xiaprojects/rb-pcb/RB-01/rb01hat/docs/generated/gpio-map.md

<!-- GENERATED by tools/netlist.py from hardware/*.csv - do not edit by hand. Run `make docs` after changing the CSVs. -->

# GPIO map - Raspberry Pi 5 40-pin header

Physical pin numbers are the header positions (pin 1 = square pad, notch end). BCM = GPIO number used by software (gpiozero, libgpiod, device tree).

## Pin-by-pin

| Pin | Name | BCM | Net | Connected to | Status / notes |
|---:|---|---:|---|---|---|
| 1 | 3V3 |  | 3V3 | 3V3 rail | used <br><sub>3.3 V supply (switched off in STANDBY)</sub> |
| 2 | 5V |  |  |  | not wired on HAT (same rail as the wired pins) <br><sub>5 V from USB-C input (present in STANDBY)</sub> |
| 3 | GPIO2 | 2 | I2C1_SDA | U1.SDA, U7.SDA | used <br><sub>I2C1 SDA; on-board ~1.8k pull-up to 3V3</sub> |
| 4 | 5V |  | 5V | 5V rail | used <br><sub>5 V</sub> |
| 5 | GPIO3 | 3 | I2C1_SCL | U1.SCL, U7.SCL | used <br><sub>I2C1 SCL; on-board ~1.8k pull-up to 3V3</sub> |
| 6 | GND |  | GND | GND rail | used |
| 7 | GPIO4 | 4 |  |  | **rb-ems** - RB-EMS: FLARM OUT (UART2 TXD) to the traffic annunciators - off-HAT <br><sub>GPCLK0; UART2 TXD (Pi 5 uart2-pi5)</sub> |
| 8 | GPIO14 | 14 |  |  | **rb-ems** - RB-EMS: UART GPS TXD - off-HAT <br><sub>UART0 TXD</sub> |
| 9 | GND |  |  |  | not wired on HAT (same rail as the wired pins) |
| 10 | GPIO15 | 15 |  |  | **rb-ems** - RB-EMS: UART GPS RXD - off-HAT <br><sub>UART0 RXD</sub> |
| 11 | GPIO17 | 17 |  |  | **rb-ems** - RB-EMS: 5th MAX31856 CS on SPI1 (ems-chtegt.json outsidetemperature; v3.0 image: OIL T.) - not in the HAT list <br><sub>SPI1 CE1</sub> |
| 12 | GPIO18 | 18 |  |  | **reserved** - SPI1 CE0 is driven by spidev1.0 (dtoverlay=spi1-1cs): do not connect (RB-EMS scheme) <br><sub>SPI1 CE0; PCM CLK; PWM0</sub> |
| 13 | GPIO27 | 27 | CHT4_CS_N | R4.2, U6.CS | used |
| 14 | GND |  |  |  | not wired on HAT (same rail as the wired pins) |
| 15 | GPIO22 | 22 |  |  | **rb-ems** - RB-EMS: engine RPM pulse input (ems-rpm.json enginerpm) - off-HAT |
| 16 | GPIO23 | 23 | EGT1_CS_N | R5.2, J11.7, J12.7, U9.CS | used |
| 17 | 3V3 |  | 3V3 | 3V3 rail | used <br><sub>3.3 V supply</sub> |
| 18 | GPIO24 | 24 | EGT3_CS_N | R7.2, J11.9, J12.9, U11.CS | used |
| 19 | GPIO10 | 10 | SPI0_MOSI | J11.4, J12.4, U9.SDI, U10.SDI, U11.SDI, U12.SDI | used <br><sub>SPI0 MOSI</sub> |
| 20 | GND |  | GND | GND rail | used |
| 21 | GPIO9 | 9 | SPI0_MISO | J11.5, J12.5, U9.SDO, U10.SDO, U11.SDO, U12.SDO | used <br><sub>SPI0 MISO</sub> |
| 22 | GPIO25 | 25 |  |  | **rb-ems** - RB-EMS: landing gear NOSE switch (ems-gpio.json gearnose) - off-HAT |
| 23 | GPIO11 | 11 | SPI0_SCLK | J11.3, J12.3, U9.SCK, U10.SCK, U11.SCK, U12.SCK | used <br><sub>SPI0 SCLK</sub> |
| 24 | GPIO8 | 8 | EGT2_CS_N | R6.2, J11.8, J12.8, U10.CS | used <br><sub>SPI0 CE0</sub> |
| 25 | GND |  | GND | GND rail | used |
| 26 | GPIO7 | 7 | EGT4_CS_N | R8.2, J11.10, J12.10, U12.CS | used <br><sub>SPI0 CE1</sub> |
| 27 | GPIO0 | 0 | I2C0_SDA | R11.2, U2.SDA, U13.SDA (DNP), U14.LSDA | used <br><sub>ID_SD; I2C0 SDA (Pi 5 i2c0-pi5)</sub> |
| 28 | GPIO1 | 1 | I2C0_SCL | R12.2, U2.SCL, U13.SCL (DNP), U14.LSCL | used <br><sub>ID_SC; I2C0 SCL (Pi 5 i2c0-pi5)</sub> |
| 29 | GPIO5 | 5 |  |  | **rb-ems** - RB-EMS v3.0 scheme: UART group with FLARM (UART2 RXD) - off-HAT; function to confirm <br><sub>UART2 RXD (Pi 5 uart2-pi5)</sub> |
| 30 | GND |  |  |  | not wired on HAT (same rail as the wired pins) |
| 31 | GPIO6 | 6 | CHT3_CS_N | R3.2, U5.CS | used |
| 32 | GPIO12 | 12 |  |  | **rb-ems** - RB-EMS: landing gear LEFT switch (ems-gpio.json gearleft) - off-HAT <br><sub>PWM0</sub> |
| 33 | GPIO13 | 13 | CHT1_CS_N | R1.2, U3.CS | used <br><sub>PWM1</sub> |
| 34 | GND |  |  |  | not wired on HAT (same rail as the wired pins) |
| 35 | GPIO19 | 19 | SPI1_MISO | U3.SDO, U4.SDO, U5.SDO, U6.SDO | used <br><sub>SPI1 MISO; PCM FS</sub> |
| 36 | GPIO16 | 16 |  |  | **rb-ems** - RB-EMS: landing gear RIGHT switch (ems-gpio.json gearright) - off-HAT <br><sub>SPI1 CE2</sub> |
| 37 | GPIO26 | 26 | CHT2_CS_N | R2.2, U4.CS | used |
| 38 | GPIO20 | 20 | SPI1_MOSI | U3.SDI, U4.SDI, U5.SDI, U6.SDI | used <br><sub>SPI1 MOSI; PCM DIN</sub> |
| 39 | GND |  | GND | GND rail | used |
| 40 | GPIO21 | 21 | SPI1_SCLK | U3.SCK, U4.SCK, U5.SCK, U6.SCK | used <br><sub>SPI1 SCLK; PCM DOUT</sub> |

## Header view (top of HAT, GPIO edge at the top, USB/Ethernet to the right)

Odd pins are the row nearer the board centre on the Pi; even pins are the row on the board edge.

| Net | Name | Pin | Pin | Name | Net |
|---|---|---:|:---|---|---|
| 3V3 | 3V3 | 1 | 2 | 5V |  |
| I2C1_SDA | GPIO2 | 3 | 4 | 5V | 5V |
| I2C1_SCL | GPIO3 | 5 | 6 | GND | GND |
|  | GPIO4 | 7 | 8 | GPIO14 |  |
|  | GND | 9 | 10 | GPIO15 |  |
|  | GPIO17 | 11 | 12 | GPIO18 |  |
| CHT4_CS_N | GPIO27 | 13 | 14 | GND |  |
|  | GPIO22 | 15 | 16 | GPIO23 | EGT1_CS_N |
| 3V3 | 3V3 | 17 | 18 | GPIO24 | EGT3_CS_N |
| SPI0_MOSI | GPIO10 | 19 | 20 | GND | GND |
| SPI0_MISO | GPIO9 | 21 | 22 | GPIO25 |  |
| SPI0_SCLK | GPIO11 | 23 | 24 | GPIO8 | EGT2_CS_N |
| GND | GND | 25 | 26 | GPIO7 | EGT4_CS_N |
| I2C0_SDA | GPIO0 | 27 | 28 | GPIO1 | I2C0_SCL |
|  | GPIO5 | 29 | 30 | GND |  |
| CHT3_CS_N | GPIO6 | 31 | 32 | GPIO12 |  |
| CHT1_CS_N | GPIO13 | 33 | 34 | GND |  |
| SPI1_MISO | GPIO19 | 35 | 36 | GPIO16 |  |
| CHT2_CS_N | GPIO26 | 37 | 38 | GPIO20 | SPI1_MOSI |
| GND | GND | 39 | 40 | GPIO21 | SPI1_SCLK |

## Signals by GPIO (allocation vs. priority)

| BCM | Pin | Net | Nodes | Highest-priority user |
|---:|---:|---|---|---|
| 0 | 27 | I2C0_SDA | R11.2, U2.SDA, U13.SDA (DNP), U14.LSDA | P2 U2 (Air quality T/RH/P/gas) |
| 1 | 28 | I2C0_SCL | R12.2, U2.SCL, U13.SCL (DNP), U14.LSCL | P2 U2 (Air quality T/RH/P/gas) |
| 2 | 3 | I2C1_SDA | U1.SDA, U7.SDA | P1 U1 (9-axis IMU) |
| 3 | 5 | I2C1_SCL | U1.SCL, U7.SCL | P1 U1 (9-axis IMU) |
| 6 | 31 | CHT3_CS_N | R3.2, U5.CS | P3 U5 (Thermocouple CHT3) |
| 7 | 26 | EGT4_CS_N | R8.2, J11.10, J12.10, U12.CS | P6 U12 (Thermocouple EGT4) |
| 8 | 24 | EGT2_CS_N | R6.2, J11.8, J12.8, U10.CS | P6 U10 (Thermocouple EGT2) |
| 9 | 21 | SPI0_MISO | J11.5, J12.5, U9.SDO, U10.SDO, U11.SDO, U12.SDO | P6 U9 (Thermocouple EGT1) |
| 10 | 19 | SPI0_MOSI | J11.4, J12.4, U9.SDI, U10.SDI, U11.SDI, U12.SDI | P6 U9 (Thermocouple EGT1) |
| 11 | 23 | SPI0_SCLK | J11.3, J12.3, U9.SCK, U10.SCK, U11.SCK, U12.SCK | P6 U9 (Thermocouple EGT1) |
| 13 | 33 | CHT1_CS_N | R1.2, U3.CS | P3 U3 (Thermocouple CHT1) |
| 19 | 35 | SPI1_MISO | U3.SDO, U4.SDO, U5.SDO, U6.SDO | P3 U3 (Thermocouple CHT1) |
| 20 | 38 | SPI1_MOSI | U3.SDI, U4.SDI, U5.SDI, U6.SDI | P3 U3 (Thermocouple CHT1) |
| 21 | 40 | SPI1_SCLK | U3.SCK, U4.SCK, U5.SCK, U6.SCK | P3 U3 (Thermocouple CHT1) |
| 23 | 16 | EGT1_CS_N | R5.2, J11.7, J12.7, U9.CS | P6 U9 (Thermocouple EGT1) |
| 24 | 18 | EGT3_CS_N | R7.2, J11.9, J12.9, U11.CS | P6 U11 (Thermocouple EGT3) |
| 26 | 37 | CHT2_CS_N | R2.2, U4.CS | P3 U4 (Thermocouple CHT2) |
| 27 | 13 | CHT4_CS_N | R4.2, U6.CS | P3 U6 (Thermocouple CHT4) |

## I2C address map

| Bus | Address | Ref | Function | Part | Fitted |
|---|---|---|---|---|---|
| I2C0 | 0x48 | U8 | 4-ch 16-bit ADC | ADS1115 breakout | yes |
| I2C0 | 0x50 | U13 | HAT ID EEPROM | CAT24C32 (SOIC-8) | no (DNP) |
| I2C0 | 0x77 | U2 | Air quality T/RH/P/gas | BME680 breakout | yes |
| I2C1 | 0x28 | U7 | Differential pressure (airspeed) | MS4525DO-DS3AI001DP | yes |
| I2C1 | 0x69 | U1 | 9-axis IMU | ICM-20948 breakout (1.8 V VDDIO + level shifter) | yes |

The ICM-20948 magnetometer (AK09916) also appears at 0x0C on I2C1 when the IMU is put in I2C bypass mode (the bring-up script does this).

## SPI chip-select map

| Ref | Function | Priority | Bus | CS net | BCM | Pin | Location |
|---|---|---:|---|---|---:|---:|---|
| U3 | Thermocouple CHT1 | P3 | SPI1 | CHT1_CS_N | 13 | 33 | HAT-Z3 |
| U4 | Thermocouple CHT2 | P3 | SPI1 | CHT2_CS_N | 26 | 37 | HAT-Z3 |
| U5 | Thermocouple CHT3 | P3 | SPI1 | CHT3_CS_N | 6 | 31 | HAT-Z3 |
| U6 | Thermocouple CHT4 | P3 | SPI1 | CHT4_CS_N | 27 | 13 | HAT-Z3 |
| U9 | Thermocouple EGT1 | P6 | SPI0 | EGT1_CS_N | 23 | 16 | EXT |
| U10 | Thermocouple EGT2 | P6 | SPI0 | EGT2_CS_N | 8 | 24 | EXT |
| U11 | Thermocouple EGT3 | P6 | SPI0 | EGT3_CS_N | 24 | 18 | EXT |
| U12 | Thermocouple EGT4 | P6 | SPI0 | EGT4_CS_N | 7 | 26 | EXT |
