xiaprojects/rb-pcb/RB-01/rb01hat/hardware/kicad/rb01hat-concept/renders/rb01hat-concept-right.jpg

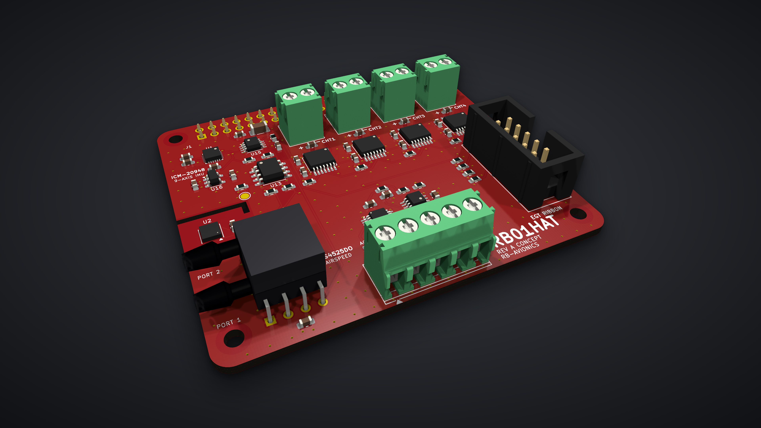
RB-01/rb01hat/hardware/kicad/rb01hat-concept/renders/rb01hat-concept-right.jpg
