xiaprojects/rb-pcb/RB-01/rb01hat/hardware/kicad/rb01hat-concept/3dmodels/SOT-23-5.step

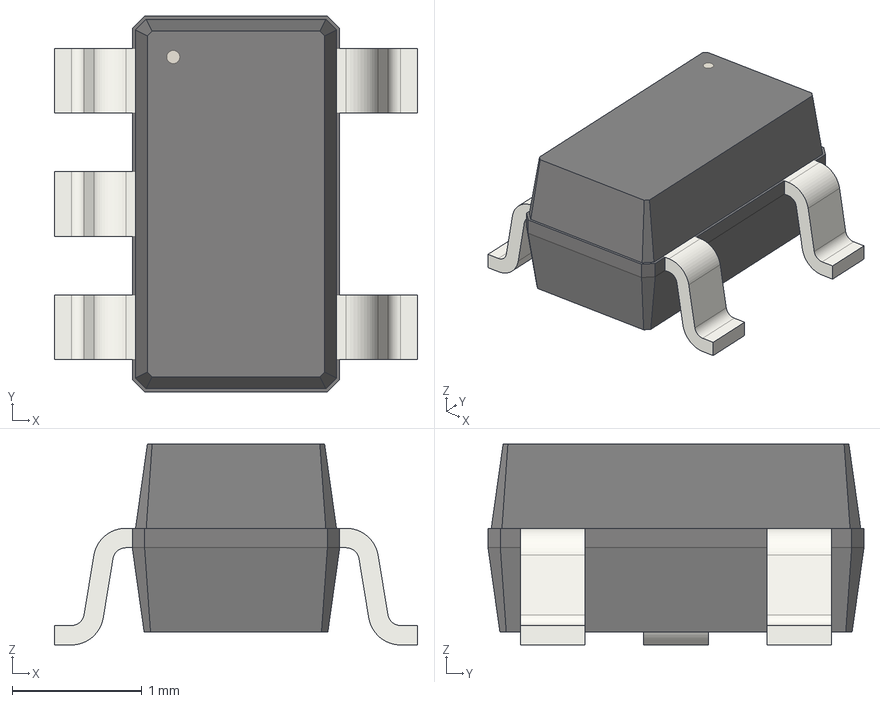
[picture p5: CAD file, 2026-11-07]
RB-01/rb01hat/hardware/kicad/rb01hat-concept/3dmodels/SOT-23-5.step
2.80 x 2.90 x 1.55 mm
