xiaprojects/rb-pcb/RB-01/rb01hat/hardware/kicad/rb01hat-concept/3dmodels/IDC-Header_2x05_P2.54mm_Vertical.step

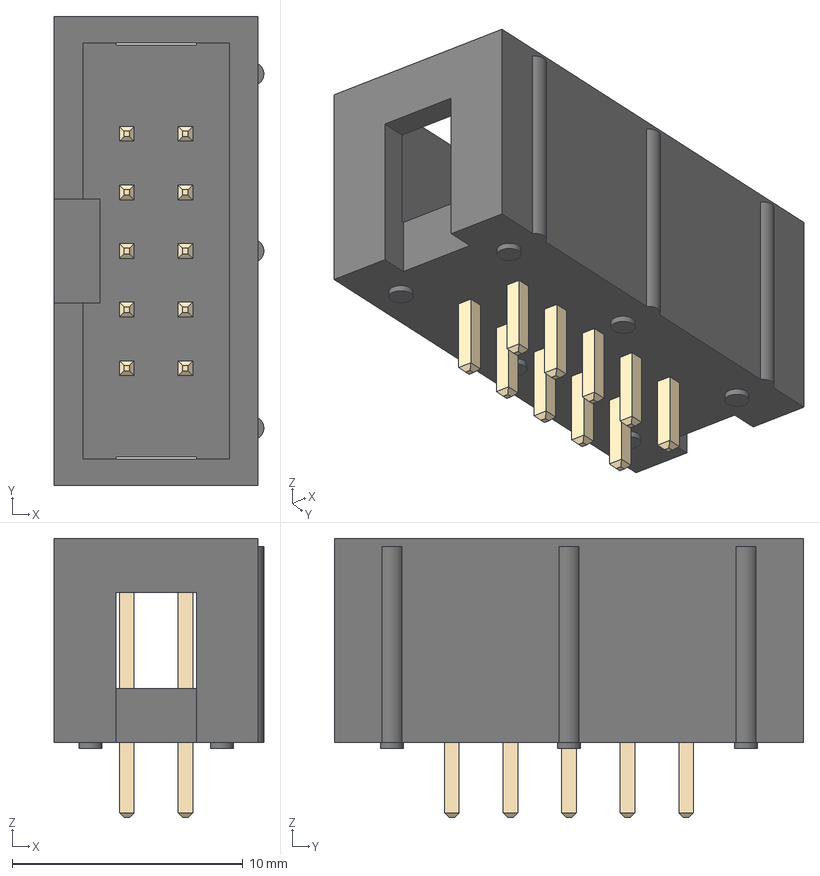
[picture p6: CAD file, 2026-11-07]
RB-01/rb01hat/hardware/kicad/rb01hat-concept/3dmodels/IDC-Header_2x05_P2.54mm_Vertical.step
9.10 x 20.4 x 12.1 mm
