xiaprojects/rb-pcb/RB-01/rb01hat/hardware/kicad/rb01hat-concept/3dmodels/C_0603_1608Metric.step

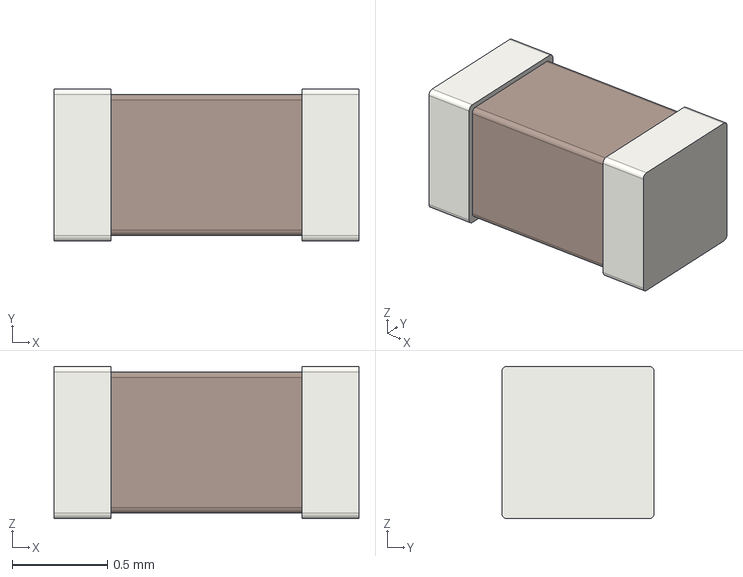
[picture p7: CAD file, 2026-11-07]
RB-01/rb01hat/hardware/kicad/rb01hat-concept/3dmodels/C_0603_1608Metric.step
1.60 x 0.8 x 0.8 mm
