xiaprojects/rb-pcb/RB-01/rb01hat/hardware/kicad/rb01hat-concept/3dmodels/QFN-24-1EP_3x3mm_P0.4mm_EP1.75x1.6mm.step

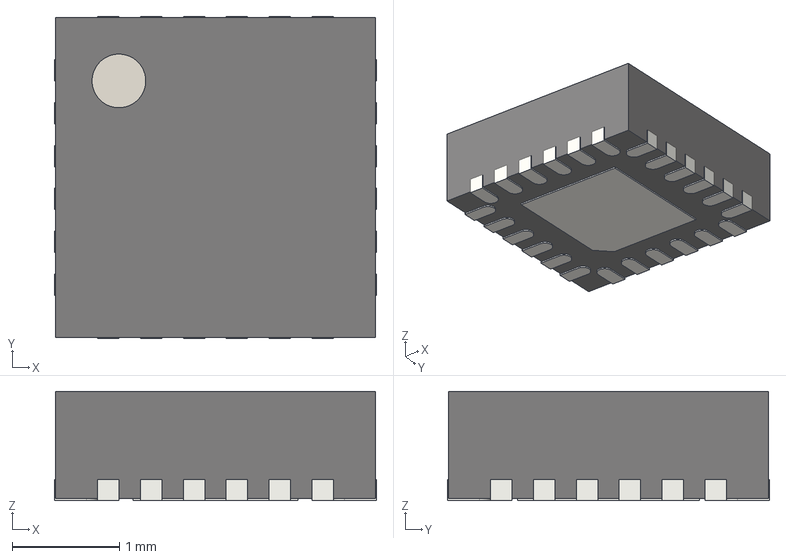
[picture p8: CAD file, 2026-11-07]
RB-01/rb01hat/hardware/kicad/rb01hat-concept/3dmodels/QFN-24-1EP_3x3mm_P0.4mm_EP1.75x1.6mm.step
3.00 x 3.00 x 1.02 mm
