xiaprojects/rb-pcb/RB-01/rb01hat/hardware/kicad/rb01hat-concept/3dmodels/SSOP-8_2.95x2.8mm_P0.65mm.step

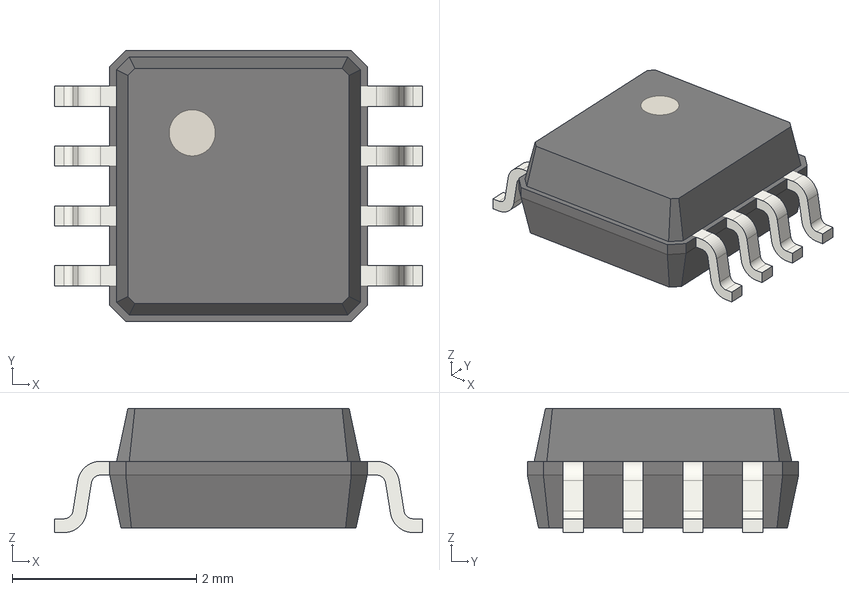
[picture p9: CAD file, 2026-11-07]
RB-01/rb01hat/hardware/kicad/rb01hat-concept/3dmodels/SSOP-8_2.95x2.8mm_P0.65mm.step
4.00 x 2.95 x 1.35 mm
