xiaprojects/rb-pcb/RB-01/rb01hat/hardware/kicad/rb01hat-concept/3dmodels/C_1206_3216Metric.step

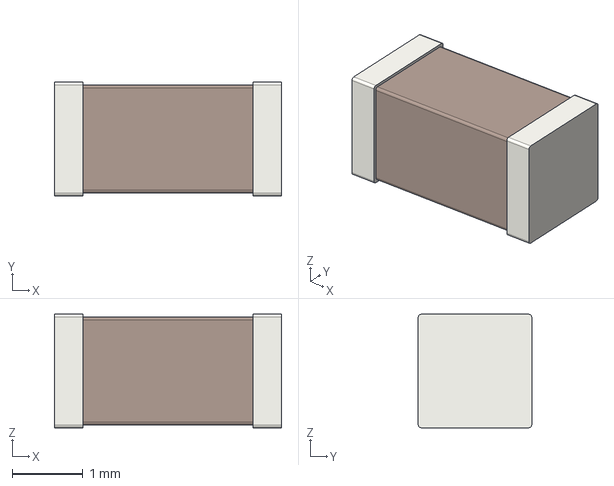
[picture p10: CAD file, 2026-11-07]
RB-01/rb01hat/hardware/kicad/rb01hat-concept/3dmodels/C_1206_3216Metric.step
3.20 x 1.60 x 1.60 mm
