xiaprojects/rb-pcb/RB-01/rb01hat/hardware/kicad/rb01hat-concept/3dmodels/TSSOP-14_4.4x5mm_P0.65mm.step

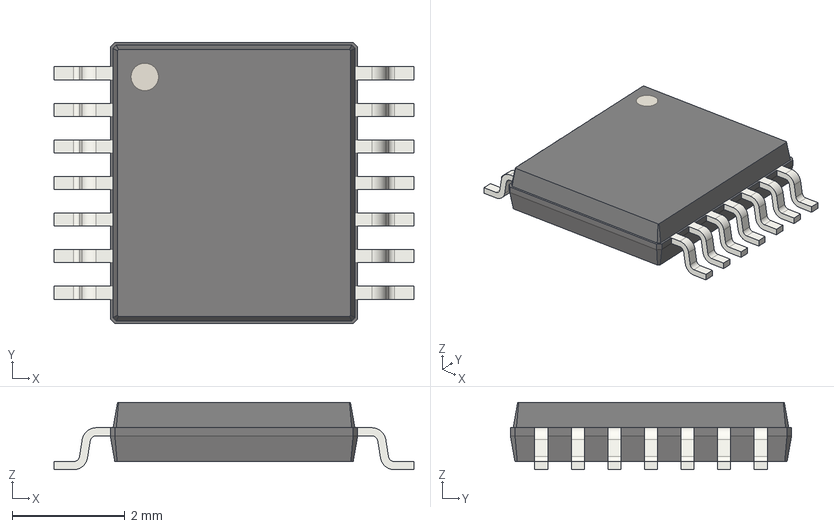
[picture p11: CAD file, 2026-11-07]
RB-01/rb01hat/hardware/kicad/rb01hat-concept/3dmodels/TSSOP-14_4.4x5mm_P0.65mm.step
6.40 x 5.00 x 1.20 mm
