xiaprojects/rb-pcb/RB-01/rb01hat/hardware/kicad/rb01hat-concept/3dmodels/Bosch_LGA-8_3x3mm_P0.8mm_ClockwisePinNumbering.step

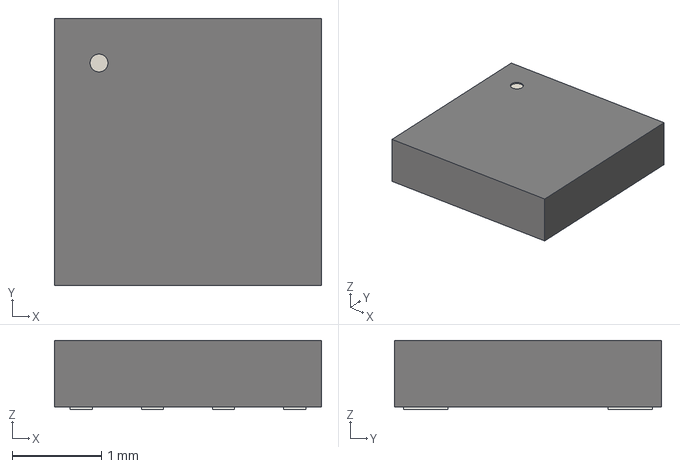
[picture p13: CAD file, 2026-11-07]
RB-01/rb01hat/hardware/kicad/rb01hat-concept/3dmodels/Bosch_LGA-8_3x3mm_P0.8mm_ClockwisePinNumbering.step
3.00 x 3.00 x 0.78 mm
