xiaprojects/rb-pcb/RB-01/rb01hat/hardware/kicad/rb01hat-concept/3dmodels/PinSocket_2x20_P2.54mm_Vertical.step

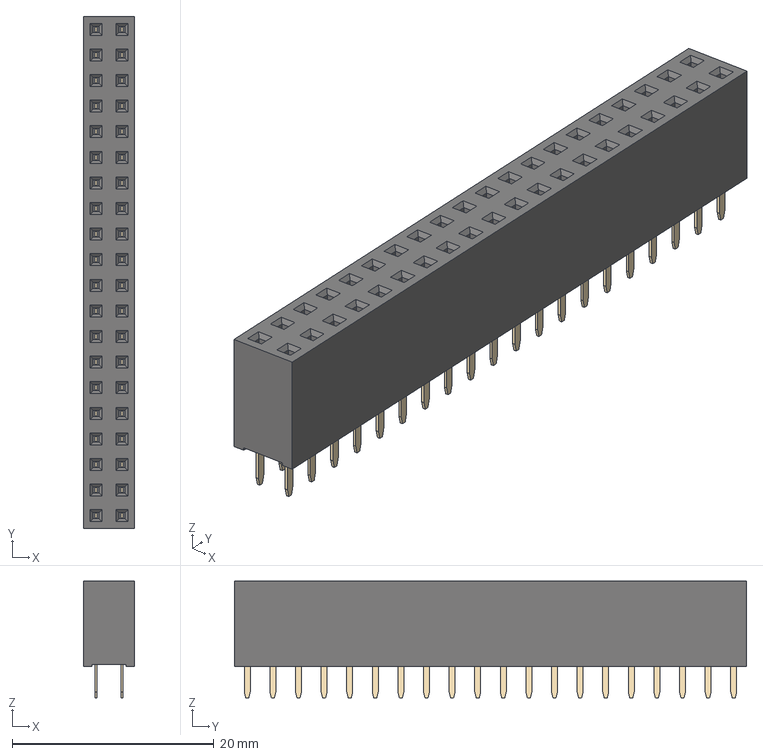
[picture p15: CAD file, 2026-11-07]
RB-01/rb01hat/hardware/kicad/rb01hat-concept/3dmodels/PinSocket_2x20_P2.54mm_Vertical.step
5.08 x 50.8 x 11.6 mm
