xiaprojects/rb-pcb/RB-01/rb01hat/hardware/kicad/rb01hat-concept/3dmodels/VSSOP-10_3x3mm_P0.5mm.step

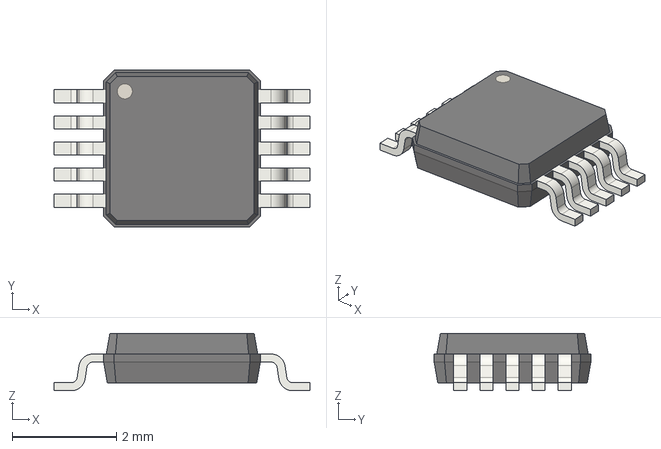
[picture p16: CAD file, 2026-11-07]
RB-01/rb01hat/hardware/kicad/rb01hat-concept/3dmodels/VSSOP-10_3x3mm_P0.5mm.step
4.90 x 3.00 x 1.10 mm
