xiaprojects/rb-pcb/RB-01/rb01hat/docs/generated/wiring-list.md

<!-- GENERATED by tools/netlist.py from hardware/*.csv - do not edit by hand. Run `make docs` after changing the CSVs. -->

# DIY wiring list

How to use this list (details in `docs/04-diy-build.md`):

- **Stage** = highest priority number among the two ends. Build and test stage by stage: stage 0 (power) first, then 1 (U1), 2 (U2), 3 (U3 U4 U5 U6), 4 (U7), 5 (U8 U14), 6 (U9 U10 U11 U12).
- Signal nets are **daisy chains**: wire each row from -> to, in order. Never star-wire a bus.
- Power nets are **rails**: connect every listed node to the proto board rail.
- Tick `[ ]` when soldered, and again in the continuity column once beeped out.
- Nodes marked (DNP) are not fitted on the DIY build: skip them.

## 3V3

Rail: connect each node to the rail.

| Stage | Node | Location | Soldered | Beeped |
|---:|---|---|:-:|:-:|
| 0 | J1.1 (3V3) | HAT-EDGE | [ ] | [ ] |
| 0 | J1.17 (3V3) | HAT-EDGE | [ ] | [ ] |
| 0 | C1.1 | HAT-EDGE | [ ] | [ ] |
| 0 | C2.1 | HAT-EDGE | [ ] | [ ] |
| 0 | U13.VCC (DNP) | HAT-EEPROM | [ ] | [ ] |
| 0 | R13.1 (DNP) | HAT-EEPROM | [ ] | [ ] |
| 1 | U1.VIN | HAT-Z1 | [ ] | [ ] |
| 2 | R11.1 | HAT-EDGE | [ ] | [ ] |
| 2 | R12.1 | HAT-EDGE | [ ] | [ ] |
| 2 | U2.VIN | HAT-Z2 | [ ] | [ ] |
| 3 | U3.VIN | HAT-Z3 | [ ] | [ ] |
| 3 | U4.VIN | HAT-Z3 | [ ] | [ ] |
| 3 | U5.VIN | HAT-Z3 | [ ] | [ ] |
| 3 | U6.VIN | HAT-Z3 | [ ] | [ ] |
| 3 | R1.1 | HAT-Z3 | [ ] | [ ] |
| 3 | R2.1 | HAT-Z3 | [ ] | [ ] |
| 3 | R3.1 | HAT-Z3 | [ ] | [ ] |
| 3 | R4.1 | HAT-Z3 | [ ] | [ ] |
| 4 | U7.VDD | HAT-Z4 | [ ] | [ ] |
| 4 | C3.1 | HAT-Z4 | [ ] | [ ] |
| 5 | U14.LV | HAT-Z5 | [ ] | [ ] |
| 6 | R5.1 | HAT-J11 | [ ] | [ ] |
| 6 | R6.1 | HAT-J11 | [ ] | [ ] |
| 6 | R7.1 | HAT-J11 | [ ] | [ ] |
| 6 | R8.1 | HAT-J11 | [ ] | [ ] |
| 6 | J11.1 | HAT-J11 | [ ] | [ ] |
| 6 | J12.1 | EXT | [ ] | [ ] |
| 6 | U9.VIN | EXT | [ ] | [ ] |
| 6 | U10.VIN | EXT | [ ] | [ ] |
| 6 | U11.VIN | EXT | [ ] | [ ] |
| 6 | U12.VIN | EXT | [ ] | [ ] |

Notes: J1.1 (3V3): Pi 3V3 (switched off in STANDBY -> sensors follow the Pi); J1.17 (3V3): Second 3V3 pin shares the load; C1.1: Bulk cap at rail entry (+); C3.1: Within 2 cm of U7; U14.LV: Translator low side follows the Pi 3V3

## 5V

Rail: connect each node to the rail.

| Stage | Node | Location | Soldered | Beeped |
|---:|---|---|:-:|:-:|
| 0 | J1.4 (5V) | HAT-EDGE | [ ] | [ ] |
| 5 | U14.HV | HAT-Z5 | [ ] | [ ] |
| 5 | U8.VDD | HAT-Z5 | [ ] | [ ] |

Notes: J1.4 (5V): Only the ADS1115 side of the translator uses 5 V

## GND

Rail: connect each node to the rail.

| Stage | Node | Location | Soldered | Beeped |
|---:|---|---|:-:|:-:|
| 0 | J1.6 (GND) | HAT-EDGE | [ ] | [ ] |
| 0 | J1.20 (GND) | HAT-EDGE | [ ] | [ ] |
| 0 | J1.25 (GND) | HAT-EDGE | [ ] | [ ] |
| 0 | J1.39 (GND) | HAT-EDGE | [ ] | [ ] |
| 0 | C1.2 | HAT-EDGE | [ ] | [ ] |
| 0 | C2.2 | HAT-EDGE | [ ] | [ ] |
| 0 | U13.VSS (DNP) | HAT-EEPROM | [ ] | [ ] |
| 0 | U13.A0 (DNP) | HAT-EEPROM | [ ] | [ ] |
| 0 | U13.A1 (DNP) | HAT-EEPROM | [ ] | [ ] |
| 0 | U13.A2 (DNP) | HAT-EEPROM | [ ] | [ ] |
| 1 | U1.GND | HAT-Z1 | [ ] | [ ] |
| 2 | U2.GND | HAT-Z2 | [ ] | [ ] |
| 3 | U3.GND | HAT-Z3 | [ ] | [ ] |
| 3 | U4.GND | HAT-Z3 | [ ] | [ ] |
| 3 | U5.GND | HAT-Z3 | [ ] | [ ] |
| 3 | U6.GND | HAT-Z3 | [ ] | [ ] |
| 4 | U7.GND | HAT-Z4 | [ ] | [ ] |
| 4 | C3.2 | HAT-Z4 | [ ] | [ ] |
| 5 | U14.GND | HAT-Z5 | [ ] | [ ] |
| 5 | U8.GND | HAT-Z5 | [ ] | [ ] |
| 5 | U8.ADDR | HAT-Z5 | [ ] | [ ] |
| 5 | J2.5 | HAT-Z5 | [ ] | [ ] |
| 6 | J11.2 | HAT-J11 | [ ] | [ ] |
| 6 | J12.2 | EXT | [ ] | [ ] |
| 6 | J11.6 | HAT-J11 | [ ] | [ ] |
| 6 | J12.6 | EXT | [ ] | [ ] |
| 6 | U9.GND | EXT | [ ] | [ ] |
| 6 | U10.GND | EXT | [ ] | [ ] |
| 6 | U11.GND | EXT | [ ] | [ ] |
| 6 | U12.GND | EXT | [ ] | [ ] |

Notes: J1.20 (GND): Next to SPI0 MOSI/MISO; J1.25 (GND): Next to SPI0 SCLK; J1.39 (GND): Next to SPI1 SCLK; U8.ADDR: ADDR to GND selects 0x48 (ems-adc.json addr); J2.5: Analog ground return; J11.6: Extra ground in the ribbon (between MISO and the CS lines)

## I2C1_SDA

| # | Stage | From | To | Run | Soldered | Beeped |
|---:|---:|---|---|---|:-:|:-:|
| 1 | 1 | J1.3 (GPIO2) | U1.SDA | HAT | [ ] | [ ] |
| 2 | 4 | U1.SDA | U7.SDA | HAT | [ ] | [ ] |

Notes: J1.3 (GPIO2): IMU / air-data bus (RB-EMS scheme)

## I2C1_SCL

| # | Stage | From | To | Run | Soldered | Beeped |
|---:|---:|---|---|---|:-:|:-:|
| 1 | 1 | J1.5 (GPIO3) | U1.SCL | HAT | [ ] | [ ] |
| 2 | 4 | U1.SCL | U7.SCL | HAT | [ ] | [ ] |

## I2C0_SDA

| # | Stage | From | To | Run | Soldered | Beeped |
|---:|---:|---|---|---|:-:|:-:|
| 1 | 2 | J1.27 (GPIO0) | R11.2 | HAT | [ ] | [ ] |
| 2 | 2 | R11.2 | U2.SDA | HAT | [ ] | [ ] |
| 3 | 2 | U2.SDA | U13.SDA (DNP) | HAT | [ ] | [ ] |
| 4 | 5 | U13.SDA (DNP) | U14.LSDA | HAT | [ ] | [ ] |

Notes: J1.27 (GPIO0): RB-EMS: ADS1115 + air quality on I2C0 (dtoverlay=i2c0-pi5)

## I2C0_SCL

| # | Stage | From | To | Run | Soldered | Beeped |
|---:|---:|---|---|---|:-:|:-:|
| 1 | 2 | J1.28 (GPIO1) | R12.2 | HAT | [ ] | [ ] |
| 2 | 2 | R12.2 | U2.SCL | HAT | [ ] | [ ] |
| 3 | 2 | U2.SCL | U13.SCL (DNP) | HAT | [ ] | [ ] |
| 4 | 5 | U13.SCL (DNP) | U14.LSCL | HAT | [ ] | [ ] |

## I2C0_SDA_5V

| # | Stage | From | To | Run | Soldered | Beeped |
|---:|---:|---|---|---|:-:|:-:|
| 1 | 5 | U14.HSDA | U8.SDA | HAT | [ ] | [ ] |

Notes: U14.HSDA: 5 V side of the translator

## I2C0_SCL_5V

| # | Stage | From | To | Run | Soldered | Beeped |
|---:|---:|---|---|---|:-:|:-:|
| 1 | 5 | U14.HSCL | U8.SCL | HAT | [ ] | [ ] |

## SPI1_SCLK

| # | Stage | From | To | Run | Soldered | Beeped |
|---:|---:|---|---|---|:-:|:-:|
| 1 | 3 | J1.40 (GPIO21) | U3.SCK | HAT | [ ] | [ ] |
| 2 | 3 | U3.SCK | U4.SCK | HAT | [ ] | [ ] |
| 3 | 3 | U4.SCK | U5.SCK | HAT | [ ] | [ ] |
| 4 | 3 | U5.SCK | U6.SCK | HAT | [ ] | [ ] |

Notes: J1.40 (GPIO21): CHT bank (ems-chtegt.json /dev/spidev1.0)

## SPI1_MOSI

| # | Stage | From | To | Run | Soldered | Beeped |
|---:|---:|---|---|---|:-:|:-:|
| 1 | 3 | J1.38 (GPIO20) | U3.SDI | HAT | [ ] | [ ] |
| 2 | 3 | U3.SDI | U4.SDI | HAT | [ ] | [ ] |
| 3 | 3 | U4.SDI | U5.SDI | HAT | [ ] | [ ] |
| 4 | 3 | U5.SDI | U6.SDI | HAT | [ ] | [ ] |

Notes: J1.38 (GPIO20): GPIO20 = SPI1 MOSI (the v3.0 image labels it MISO)

## SPI1_MISO

| # | Stage | From | To | Run | Soldered | Beeped |
|---:|---:|---|---|---|:-:|:-:|
| 1 | 3 | J1.35 (GPIO19) | U3.SDO | HAT | [ ] | [ ] |
| 2 | 3 | U3.SDO | U4.SDO | HAT | [ ] | [ ] |
| 3 | 3 | U4.SDO | U5.SDO | HAT | [ ] | [ ] |
| 4 | 3 | U5.SDO | U6.SDO | HAT | [ ] | [ ] |

Notes: J1.35 (GPIO19): GPIO19 = SPI1 MISO (the v3.0 image labels it MOSI)

## CHT1_CS_N

| # | Stage | From | To | Run | Soldered | Beeped |
|---:|---:|---|---|---|:-:|:-:|
| 1 | 3 | J1.33 (GPIO13) | R1.2 | HAT | [ ] | [ ] |
| 2 | 3 | R1.2 | U3.CS | HAT | [ ] | [ ] |

Notes: J1.33 (GPIO13): GPIO13

## CHT2_CS_N

| # | Stage | From | To | Run | Soldered | Beeped |
|---:|---:|---|---|---|:-:|:-:|
| 1 | 3 | J1.37 (GPIO26) | R2.2 | HAT | [ ] | [ ] |
| 2 | 3 | R2.2 | U4.CS | HAT | [ ] | [ ] |

Notes: J1.37 (GPIO26): GPIO26

## CHT3_CS_N

| # | Stage | From | To | Run | Soldered | Beeped |
|---:|---:|---|---|---|:-:|:-:|
| 1 | 3 | J1.31 (GPIO6) | R3.2 | HAT | [ ] | [ ] |
| 2 | 3 | R3.2 | U5.CS | HAT | [ ] | [ ] |

Notes: J1.31 (GPIO6): GPIO6

## CHT4_CS_N

| # | Stage | From | To | Run | Soldered | Beeped |
|---:|---:|---|---|---|:-:|:-:|
| 1 | 3 | J1.13 (GPIO27) | R4.2 | HAT | [ ] | [ ] |
| 2 | 3 | R4.2 | U6.CS | HAT | [ ] | [ ] |

Notes: J1.13 (GPIO27): GPIO27

## SPI0_SCLK

| # | Stage | From | To | Run | Soldered | Beeped |
|---:|---:|---|---|---|:-:|:-:|
| 1 | 6 | J1.23 (GPIO11) | J11.3 | HAT | [ ] | [ ] |
| 2 | 6 | J11.3 | J12.3 | ribbon (IDC) | [ ] | [ ] |
| 3 | 6 | J12.3 | U9.SCK | EXT carrier | [ ] | [ ] |
| 4 | 6 | U9.SCK | U10.SCK | EXT carrier | [ ] | [ ] |
| 5 | 6 | U10.SCK | U11.SCK | EXT carrier | [ ] | [ ] |
| 6 | 6 | U11.SCK | U12.SCK | EXT carrier | [ ] | [ ] |

Notes: J1.23 (GPIO11): EGT bank (ems-chtegt.json /dev/spidev0.0)

## SPI0_MOSI

| # | Stage | From | To | Run | Soldered | Beeped |
|---:|---:|---|---|---|:-:|:-:|
| 1 | 6 | J1.19 (GPIO10) | J11.4 | HAT | [ ] | [ ] |
| 2 | 6 | J11.4 | J12.4 | ribbon (IDC) | [ ] | [ ] |
| 3 | 6 | J12.4 | U9.SDI | EXT carrier | [ ] | [ ] |
| 4 | 6 | U9.SDI | U10.SDI | EXT carrier | [ ] | [ ] |
| 5 | 6 | U10.SDI | U11.SDI | EXT carrier | [ ] | [ ] |
| 6 | 6 | U11.SDI | U12.SDI | EXT carrier | [ ] | [ ] |

## SPI0_MISO

| # | Stage | From | To | Run | Soldered | Beeped |
|---:|---:|---|---|---|:-:|:-:|
| 1 | 6 | J1.21 (GPIO9) | J11.5 | HAT | [ ] | [ ] |
| 2 | 6 | J11.5 | J12.5 | ribbon (IDC) | [ ] | [ ] |
| 3 | 6 | J12.5 | U9.SDO | EXT carrier | [ ] | [ ] |
| 4 | 6 | U9.SDO | U10.SDO | EXT carrier | [ ] | [ ] |
| 5 | 6 | U10.SDO | U11.SDO | EXT carrier | [ ] | [ ] |
| 6 | 6 | U11.SDO | U12.SDO | EXT carrier | [ ] | [ ] |

## EGT1_CS_N

| # | Stage | From | To | Run | Soldered | Beeped |
|---:|---:|---|---|---|:-:|:-:|
| 1 | 6 | J1.16 (GPIO23) | R5.2 | HAT | [ ] | [ ] |
| 2 | 6 | R5.2 | J11.7 | HAT | [ ] | [ ] |
| 3 | 6 | J11.7 | J12.7 | ribbon (IDC) | [ ] | [ ] |
| 4 | 6 | J12.7 | U9.CS | EXT carrier | [ ] | [ ] |

Notes: J1.16 (GPIO23): GPIO23

## EGT2_CS_N

| # | Stage | From | To | Run | Soldered | Beeped |
|---:|---:|---|---|---|:-:|:-:|
| 1 | 6 | J1.24 (GPIO8) | R6.2 | HAT | [ ] | [ ] |
| 2 | 6 | R6.2 | J11.8 | HAT | [ ] | [ ] |
| 3 | 6 | J11.8 | J12.8 | ribbon (IDC) | [ ] | [ ] |
| 4 | 6 | J12.8 | U10.CS | EXT carrier | [ ] | [ ] |

Notes: J1.24 (GPIO8): GPIO8 (kernel CE0 must be released: dtoverlay=spi0-0cs)

## EGT3_CS_N

| # | Stage | From | To | Run | Soldered | Beeped |
|---:|---:|---|---|---|:-:|:-:|
| 1 | 6 | J1.18 (GPIO24) | R7.2 | HAT | [ ] | [ ] |
| 2 | 6 | R7.2 | J11.9 | HAT | [ ] | [ ] |
| 3 | 6 | J11.9 | J12.9 | ribbon (IDC) | [ ] | [ ] |
| 4 | 6 | J12.9 | U11.CS | EXT carrier | [ ] | [ ] |

Notes: J1.18 (GPIO24): GPIO24

## EGT4_CS_N

| # | Stage | From | To | Run | Soldered | Beeped |
|---:|---:|---|---|---|:-:|:-:|
| 1 | 6 | J1.26 (GPIO7) | R8.2 | HAT | [ ] | [ ] |
| 2 | 6 | R8.2 | J11.10 | HAT | [ ] | [ ] |
| 3 | 6 | J11.10 | J12.10 | ribbon (IDC) | [ ] | [ ] |
| 4 | 6 | J12.10 | U12.CS | EXT carrier | [ ] | [ ] |

Notes: J1.26 (GPIO7): GPIO7 (kernel CE1 must be released: dtoverlay=spi0-0cs)

## ADC_A0

| # | Stage | From | To | Run | Soldered | Beeped |
|---:|---:|---|---|---|:-:|:-:|
| 1 | 5 | J2.1 | U8.A0 | HAT | [ ] | [ ] |

Notes: J2.1: ems-adc.json channel 0: oil temperature probe

## ADC_A1

| # | Stage | From | To | Run | Soldered | Beeped |
|---:|---:|---|---|---|:-:|:-:|
| 1 | 5 | J2.2 | U8.A1 | HAT | [ ] | [ ] |

Notes: J2.2: ems-adc.json channel 1: rail50 (v3.0 image: fuel pressure)

## ADC_A2

| # | Stage | From | To | Run | Soldered | Beeped |
|---:|---:|---|---|---|:-:|:-:|
| 1 | 5 | J2.3 | U8.A2 | HAT | [ ] | [ ] |

Notes: J2.3: ems-adc.json channel 2: battery voltage (external divider)

## ADC_A3

| # | Stage | From | To | Run | Soldered | Beeped |
|---:|---:|---|---|---|:-:|:-:|
| 1 | 5 | J2.4 | U8.A3 | HAT | [ ] | [ ] |

Notes: J2.4: ems-adc.json channel 3: oil pressure

## EEPROM_WP

| # | Stage | From | To | Run | Soldered | Beeped |
|---:|---:|---|---|---|:-:|:-:|
| 1 | 0 | U13.WP (DNP) | R13.2 (DNP) | HAT | [ ] | [ ] |
| 2 | 0 | R13.2 (DNP) | TP1.1 (DNP) | HAT | [ ] | [ ] |

## Deliberately unconnected pins

| Pin | Why |
|---|---|
| U1.AD0 | Module default = 0x69 |
| U1.INT | No free GPIO in the RB-EMS scheme: software polls |
| U2.SDO | Module default sets the address (0x76 or 0x77) |
| U2.CS | Module pulls CSB high = I2C mode |
| U8.ALRT | No free GPIO: rb-ems-go polls the conversion |
| U3.FLT | No free GPIO: faults read from the status register (0x0F) |
| U4.FLT | see first row of this ref |
| U5.FLT | see first row of this ref |
| U6.FLT | see first row of this ref |
| U9.FLT | see first row of this ref |
| U10.FLT | see first row of this ref |
| U11.FLT | see first row of this ref |
| U12.FLT | see first row of this ref |
| U3.DRDY | Not used: software polls |
| U4.DRDY | see first row of this ref |
| U5.DRDY | see first row of this ref |
| U6.DRDY | see first row of this ref |
| U9.DRDY | see first row of this ref |
| U10.DRDY | see first row of this ref |
| U11.DRDY | see first row of this ref |
| U12.DRDY | see first row of this ref |
