xiaprojects/rb-pcb/RB-01/rb01hat/hardware/kicad/rb01hat-concept/rb01hat-concept.kicad_pcb

## KiCad design RB-01/rb01hat/hardware/kicad/rb01hat-concept/rb01hat-concept.kicad_pcb (2026-11-07)

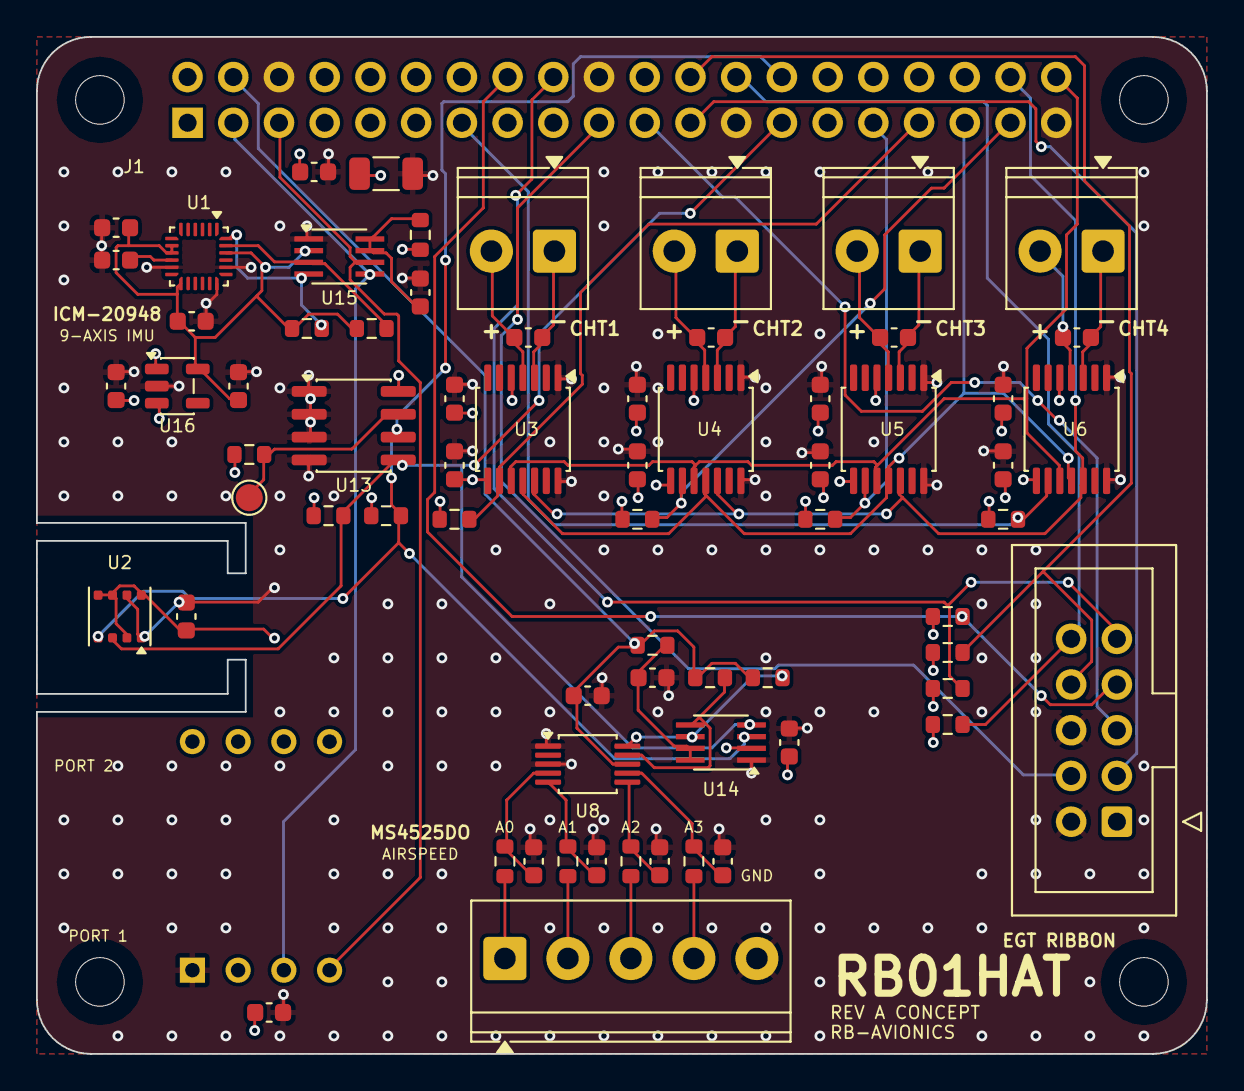
[picture p19: board rb01hat-concept.kicad_pcb from above]

Board: 4 copper layers, 65.0 x 56.5 mm, 74 parts (1 on the bottom side), 46 nets.

Parts:
C1: 22u; C_1206_3216Metric
C2, C3, C4, C5, C6, C7, C8, C9, C10, C11, C12, C13, C14, C15, C16, C17, C18, C22, C23, C24, C26, C27, C28, C29: 100n; C_0603_1608Metric
C19, C20: 1u; C_0603_1608Metric
C21, C25: 100p; C_0603_1608Metric
H1, H2, H3, H4: M2.5; MountingHole_2.7mm_M2.5
J1: Pi 5 GPIO; PinSocket_2x20_P2.54mm_Vertical
J2: ADC IN; TerminalBlock_Phoenix_PT-1,5-5-3.5-H_1x05_P3.50mm_Horizontal
J3: CHT1; TerminalBlock_Phoenix_PT-1,5-2-3.5-H_1x02_P3.50mm_Horizontal
J4: CHT2; TerminalBlock_Phoenix_PT-1,5-2-3.5-H_1x02_P3.50mm_Horizontal
J5: CHT3; TerminalBlock_Phoenix_PT-1,5-2-3.5-H_1x02_P3.50mm_Horizontal
J6: CHT4; TerminalBlock_Phoenix_PT-1,5-2-3.5-H_1x02_P3.50mm_Horizontal
J11: EGT ribbon; IDC-Header_2x05_P2.54mm_Vertical
R1, R2, R3, R4, R5, R6, R7, R8, R17, R18: 10k; R_0603_1608Metric
R11, R12: 3k9; R_0603_1608Metric
R13, R20, R21, R22, R23: 1k; R_0603_1608Metric
R14, R19: 200k; R_0603_1608Metric
R15, R16: 2k2; R_0603_1608Metric
TP1: WP; TestPoint_Pad_D1.5mm
U1: ICM-20948; QFN-24-1EP_3x3mm_P0.4mm_EP1.75x1.6mm
U2: BME680; Bosch_LGA-8_3x3mm_P0.8mm_ClockwisePinNumbering
U3, U4, U5, U6: MAX31856; TSSOP-14_4.4x5mm_P0.65mm
U7: MS4525DO; MS4525DO_DS_DIP-8
U8: ADS1115; VSSOP-10_3x3mm_P0.5mm
U13: CAT24C32; SOIC-8_3.9x4.9mm_P1.27mm
U14, U15: PCA9306; SSOP-8_2.95x2.8mm_P0.65mm
U16: AP2112K-1.8; SOT-23-5

Connections:
1V8: C16.1, C17.1, C20.1, R15.1, R16.1, U1.8, U1.9, U1.13, U1.22, U15.2, U16.5
3V3: C1.1, C2.1, C3.1, C4.1, C5.1, C7.1, C8.1, C10.1, C11.1, C13.1, C14.1, C19.1, C22.1, C24.1, J1.1, J1.17, J11.1, R1.1, R2.1, R3.1, R4.1, R5.1, R6.1, R7.1, R8.1, R11.1, R12.1, R13.1, R14.1, U2.2, U2.5, U2.6, U2.8, U3.5, U3.8, U4.5, U4.8, U5.5, U5.8, U6.5, U6.8, U7.2, U13.8, U14.2, U16.1, U16.3
5V: C23.1, J1.4, R17.1, R18.1, R19.1, U8.8
ADC_A0: J2.1, R20.1
ADC_A0_F: C26.1, R20.2, U8.4
ADC_A1: J2.2, R21.1
ADC_A1_F: C27.1, R21.2, U8.5
ADC_A2: J2.3, R22.1
ADC_A2_F: C28.1, R22.2, U8.6
ADC_A3: J2.4, R23.1
ADC_A3_F: C29.1, R23.2, U8.7
CHT1_CS_N: J1.33, R1.2, U3.9
CHT1_TN: C6.2, J3.1, U3.3
CHT1_TP: C6.1, J3.2, U3.4
CHT2_CS_N: J1.37, R2.2, U4.9
CHT2_TN: C9.2, J4.1, U4.3
CHT2_TP: C9.1, J4.2, U4.4
CHT3_CS_N: J1.31, R3.2, U5.9
CHT3_TN: C12.2, J5.1, U5.3
CHT3_TP: C12.1, J5.2, U5.4
CHT4_CS_N: J1.13, R4.2, U6.9
CHT4_TN: C15.2, J6.1, U6.3
CHT4_TP: C15.1, J6.2, U6.4
EEPROM_WP: R13.2, TP1.1, U13.7
EGT1_CS_N: J1.16, J11.7, R5.2
EGT2_CS_N: J1.24, J11.8, R6.2
EGT3_CS_N: J1.18, J11.9, R7.2
EGT4_CS_N: J1.26, J11.10, R8.2
GND: C1.2, C2.2, C3.2, C4.2, C5.2, C7.2, C8.2, C10.2, C11.2, C13.2, C14.2, C16.2, C17.2, C18.2, C19.2, C20.2, C21.2, C22.2, C23.2, C24.2, C25.2, C26.2, C27.2, C28.2, C29.2, J1.6, J1.20, J1.25, J1.39, J2.5, J11.2, J11.6, U1.11, U1.18, U1.20, U2.1, U2.7, U3.1, U3.14, U4.1, U4.14, U5.1, U5.14, U6.1, U6.14, U7.1, U8.1, U8.3, U13.1, U13.2, U13.3, U13.4, U14.1, U15.1, U16.2
I2C0_EN: C25.1, R19.2, U14.7, U14.8
I2C0_SCL: J1.28, R12.2, U2.4, U13.6, U14.3
I2C0_SCL_5V: R18.2, U8.10, U14.6
I2C0_SDA: J1.27, R11.2, U2.3, U13.5, U14.4
I2C0_SDA_5V: R17.2, U8.9, U14.5
I2C1_EN: C21.1, R14.2, U15.7, U15.8
I2C1_SCL: J1.5, U7.4, U15.6
I2C1_SCL_1V8: R16.2, U1.23, U15.3
I2C1_SDA: J1.3, U7.3, U15.5
I2C1_SDA_1V8: R15.2, U1.24, U15.4
IMU_REGOUT: C18.1, U1.10
SPI0_MISO: J1.21, J11.5
SPI0_MOSI: J1.19, J11.4
SPI0_SCLK: J1.23, J11.3
SPI1_MISO: J1.35, U3.11, U4.11, U5.11, U6.11
SPI1_MOSI: J1.38, U3.12, U4.12, U5.12, U6.12
SPI1_SCLK: J1.40, U3.10, U4.10, U5.10, U6.10
