xiaprojects/rb-pcb/(notices)

Notices in the files:
RB-01/rb01hat/hardware/kicad/rb01hat-concept/3dmodels/C_1206_3216Metric.step:
Copyright (C) 2017, kicad StepUp
This work is licensed under the [Creative Commons CC-BY-SA 4.0 License](https://creativecommons.org/licenses/by-sa/4.0/legalcode),
with the following exception:
To the extent that the creation of electronic designs that use 'Licensed Material' can be considered to be 'Adapted Material',
You are free to use the library data in your own projects without the obligation to share your project files under this or any other license agreement.
RB-01/rb01hat/hardware/kicad/rb01hat-concept/3dmodels/R_0603_1608Metric.step:
Copyright (C) 2018, kicad StepUp
RB-01/rb01hat/hardware/kicad/rb01hat-concept/3dmodels/QFN-24-1EP_3x3mm_P0.4mm_EP1.75x1.6mm.step:
This program is free software: you can redistribute it and/or modify
it under the terms of the GNU General Public License as published by
the Free Software Foundation, either version 3 of the License, or
any later version.
itself might be covered by the GNU General Public License.
RB-01/rb01hat/hardware/kicad/rb01hat-concept/3dmodels/SOIC-8_3.9x4.9mm_P1.27mm.step:
Copyright (C) 2025, KiCAD
This work is licensed under the
[Creative Commons CC-BY-SA 4.0 License](https://creativecommons.org/licenses/by-sa/4.0/legalcode),
project files under this or any other license agreement. However, if you wish to distribute
RB-01/rb01hat/hardware/kicad/rb01hat-concept/3dmodels/PinSocket_2x20_P2.54mm_Vertical.step:
Copyright (C) 2024, KiCAD
RB-01/rb01hat/hardware/kicad/rb01hat-concept/3dmodels/TerminalBlock_Phoenix_PT-1,5-5-3.5-H_1x05_P3.50mm_Horizontal.step:
Copyright (C) 2026, KiCAD
